sergio73/WordClock/Images/IMG-20160116-WA0003.jpg

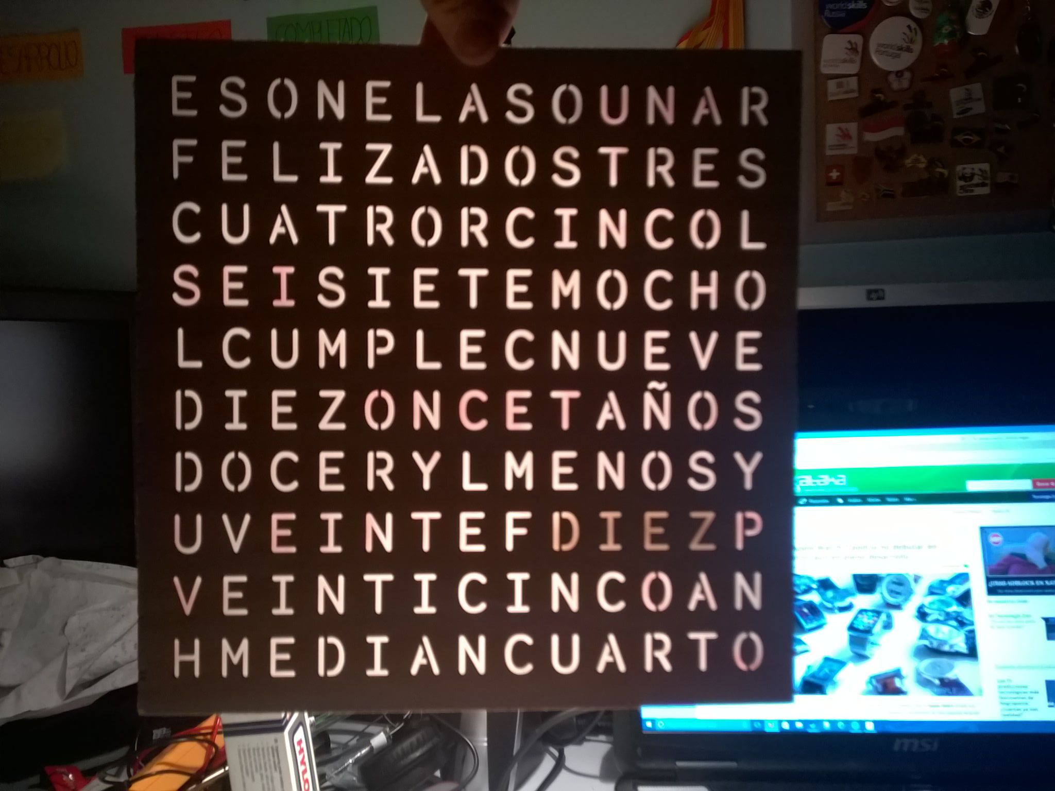
Images/IMG-20160116-WA0003.jpg
