sergio73/WordClock/Images/IMG-20160123-WA0004.jpg

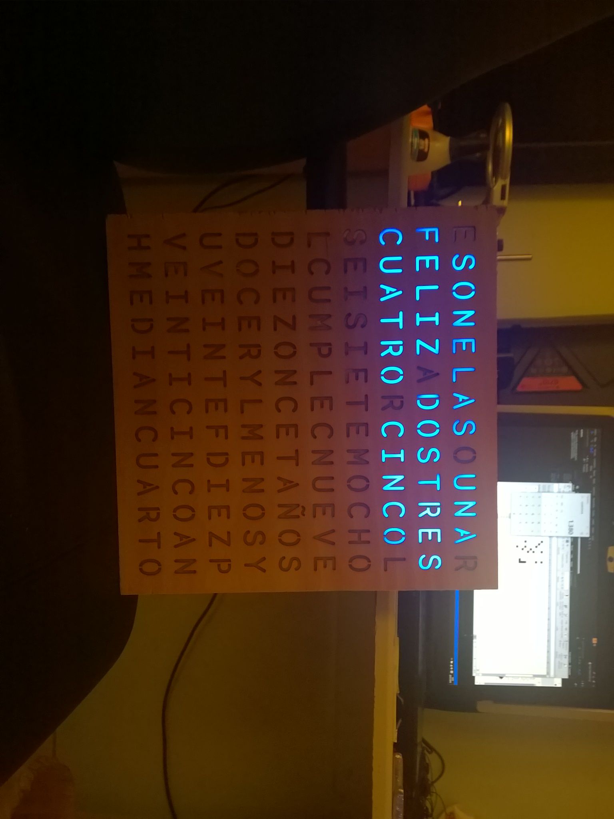
Images/IMG-20160123-WA0004.jpg
