sergio73/WordClock/Images/WP_20160220_19_48_40_Pro.jpg

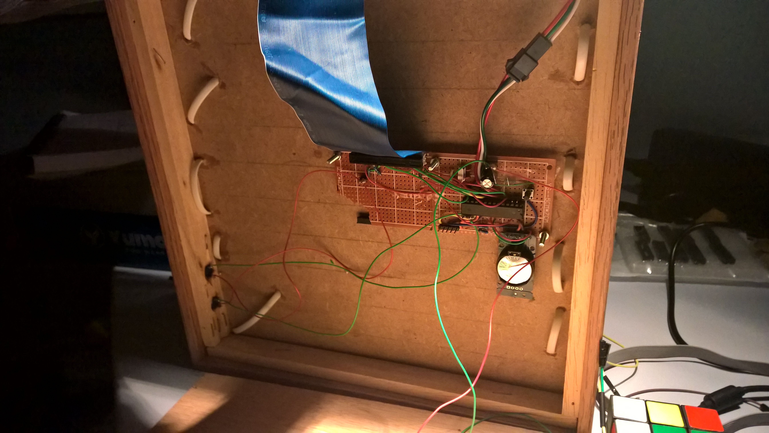
Images/WP_20160220_19_48_40_Pro.jpg
