sergio73/WordClock/Images/WP_20160220_19_48_58_Pro.jpg

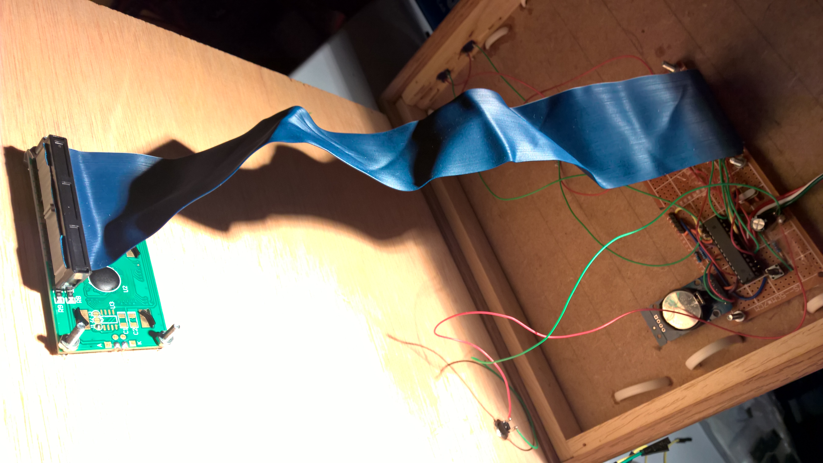
Images/WP_20160220_19_48_58_Pro.jpg
