sergio73/WordClock/(commit log)

2016-02-06 Confirmación inicial para agregar los archivos .gitIgnore y .gitAttribute predeterminados.
2017-06-22 Update WordClockV2.ino
    Change the initialization to turn one by one all the leds
